reddevil578/speaker-switcher-remote/README.md

# speaker-switcher-remote
12V remote controlled audio component trigger as KiCAD project
