reddevil578/speaker-switcher-remote/PDF/speaker-switcher-remote-F_SilkS.pdf

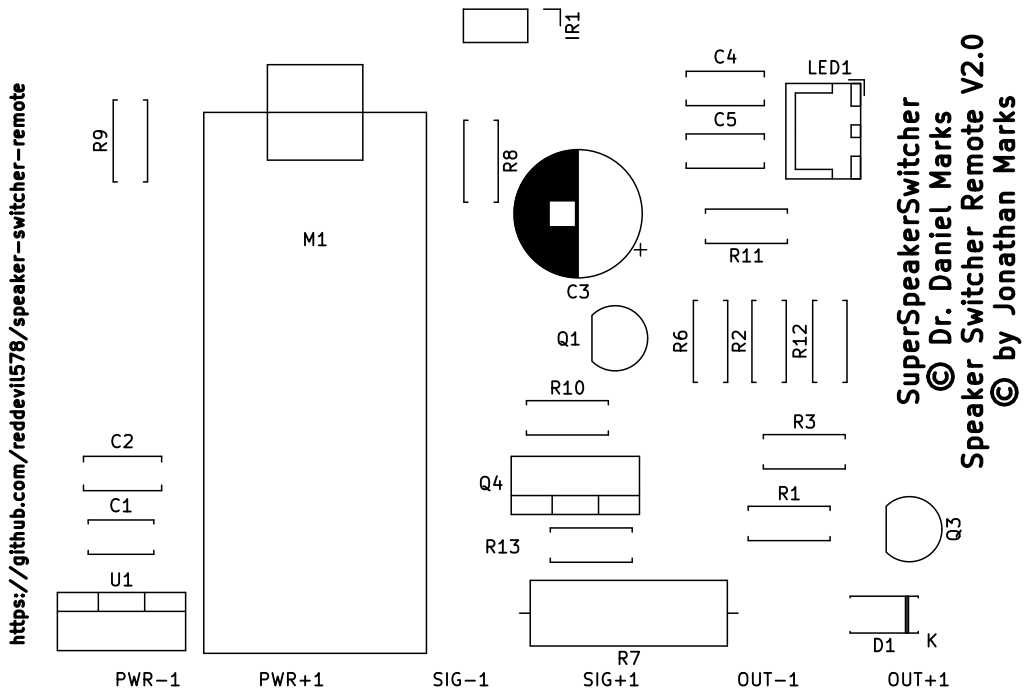
[picture p1: page 1]

https://github.com/reddevil578/speaker-switcher-remote SuperSpeakerSwitcher © Dr. Daniel Marks Speaker Switcher Remote V2.0 © by Jonathan Marks
