reddevil578/speaker-switcher-remote/PDF/speaker-switcher-remote-B_Cu.pdf

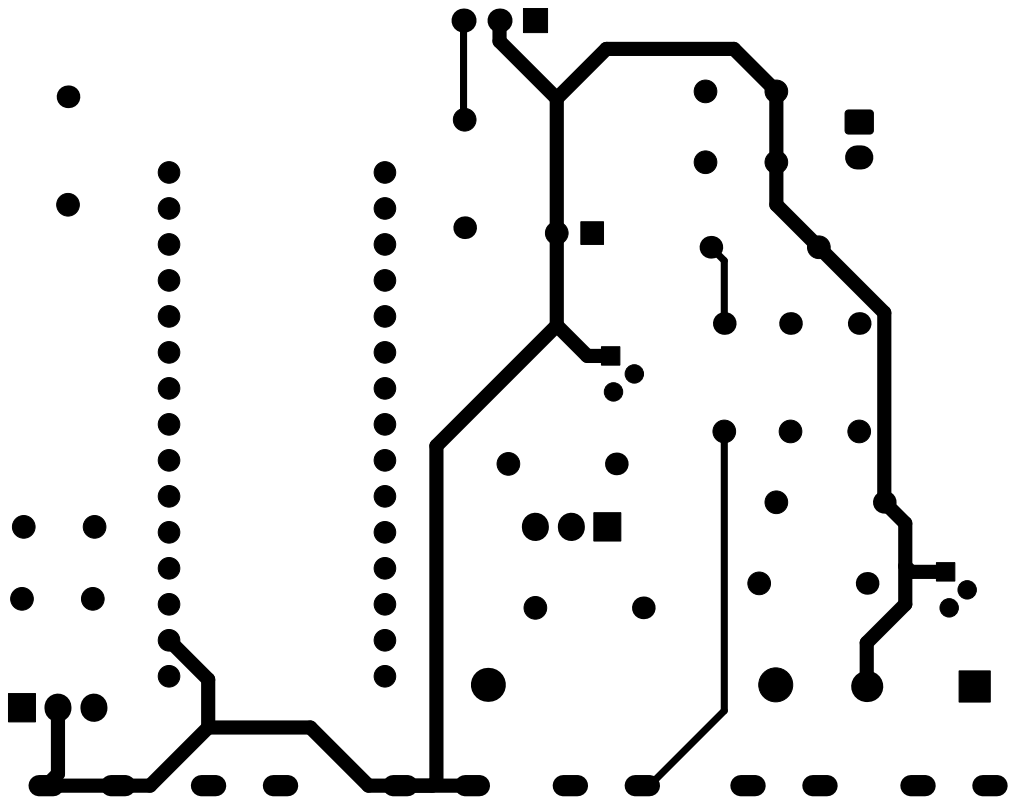
[picture p2: page 1]
