reddevil578/speaker-switcher-remote/PDF/speaker-switcher-remote-B_Mask.pdf

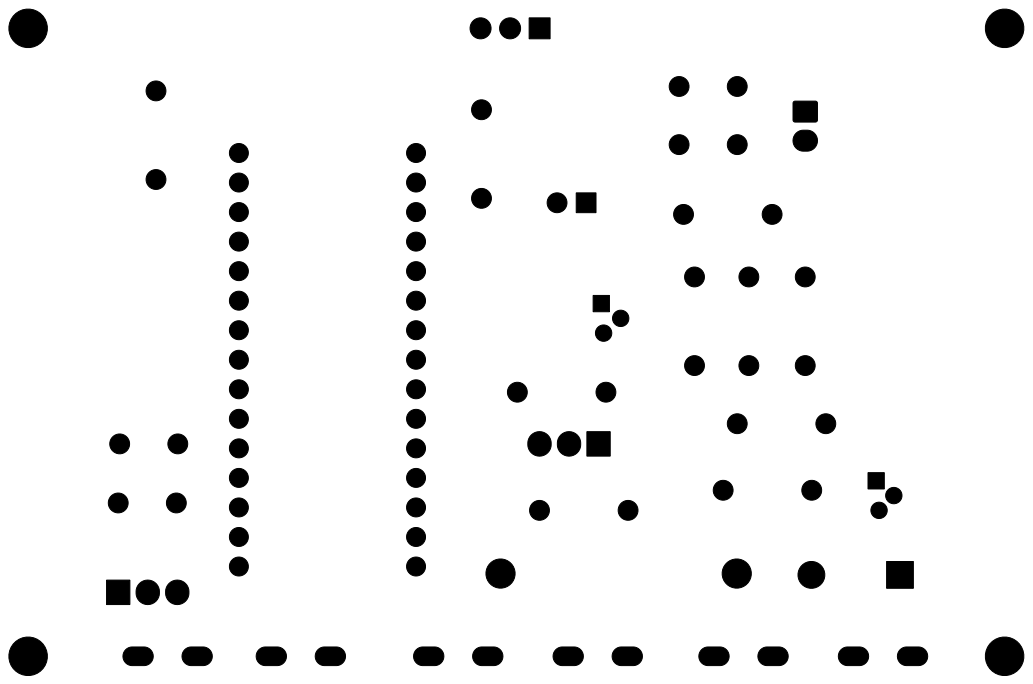
[picture p3: page 1]
