reddevil578/speaker-switcher-remote/PDF/speaker-switcher-remote-F_Cu.pdf

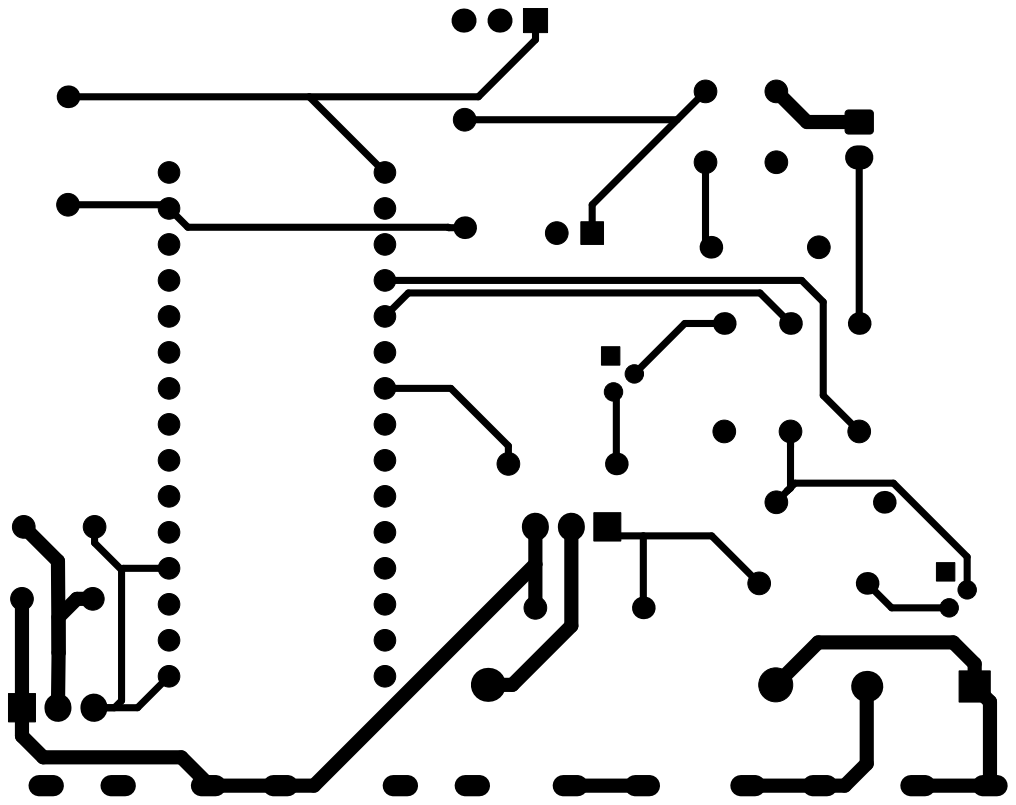
[picture p4: page 1]
