reddevil578/speaker-switcher-remote/PDF/speaker-switcher-remote-F_Fab.pdf

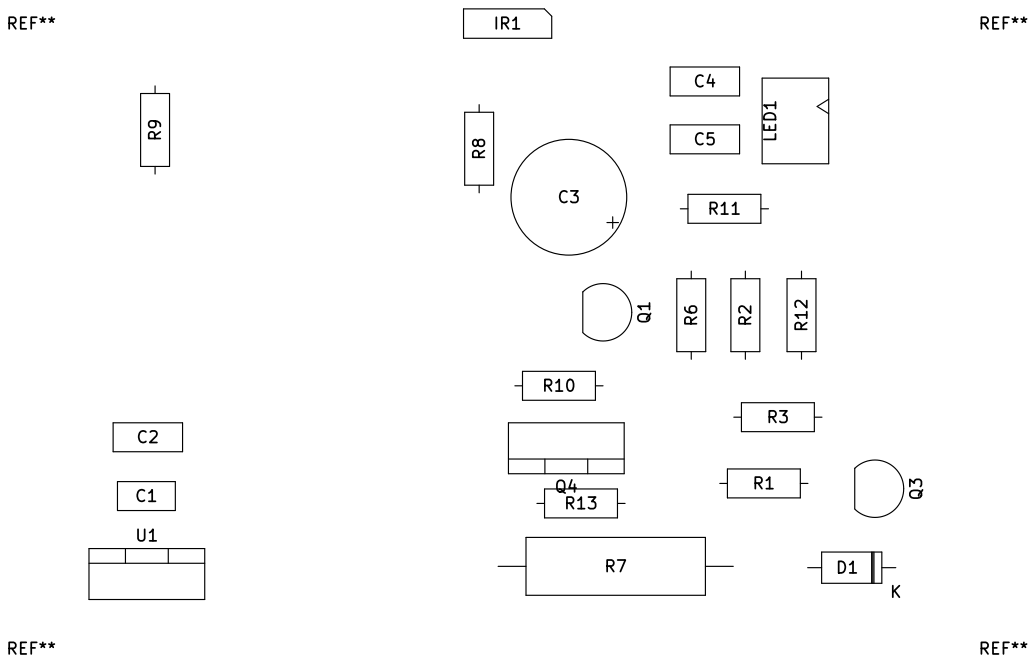
[picture p5: page 1]
