reddevil578/speaker-switcher-remote/speaker-switcher-remote.kicad_pcb

## KiCad design speaker-switcher-remote.kicad_pcb (2021-03-07)

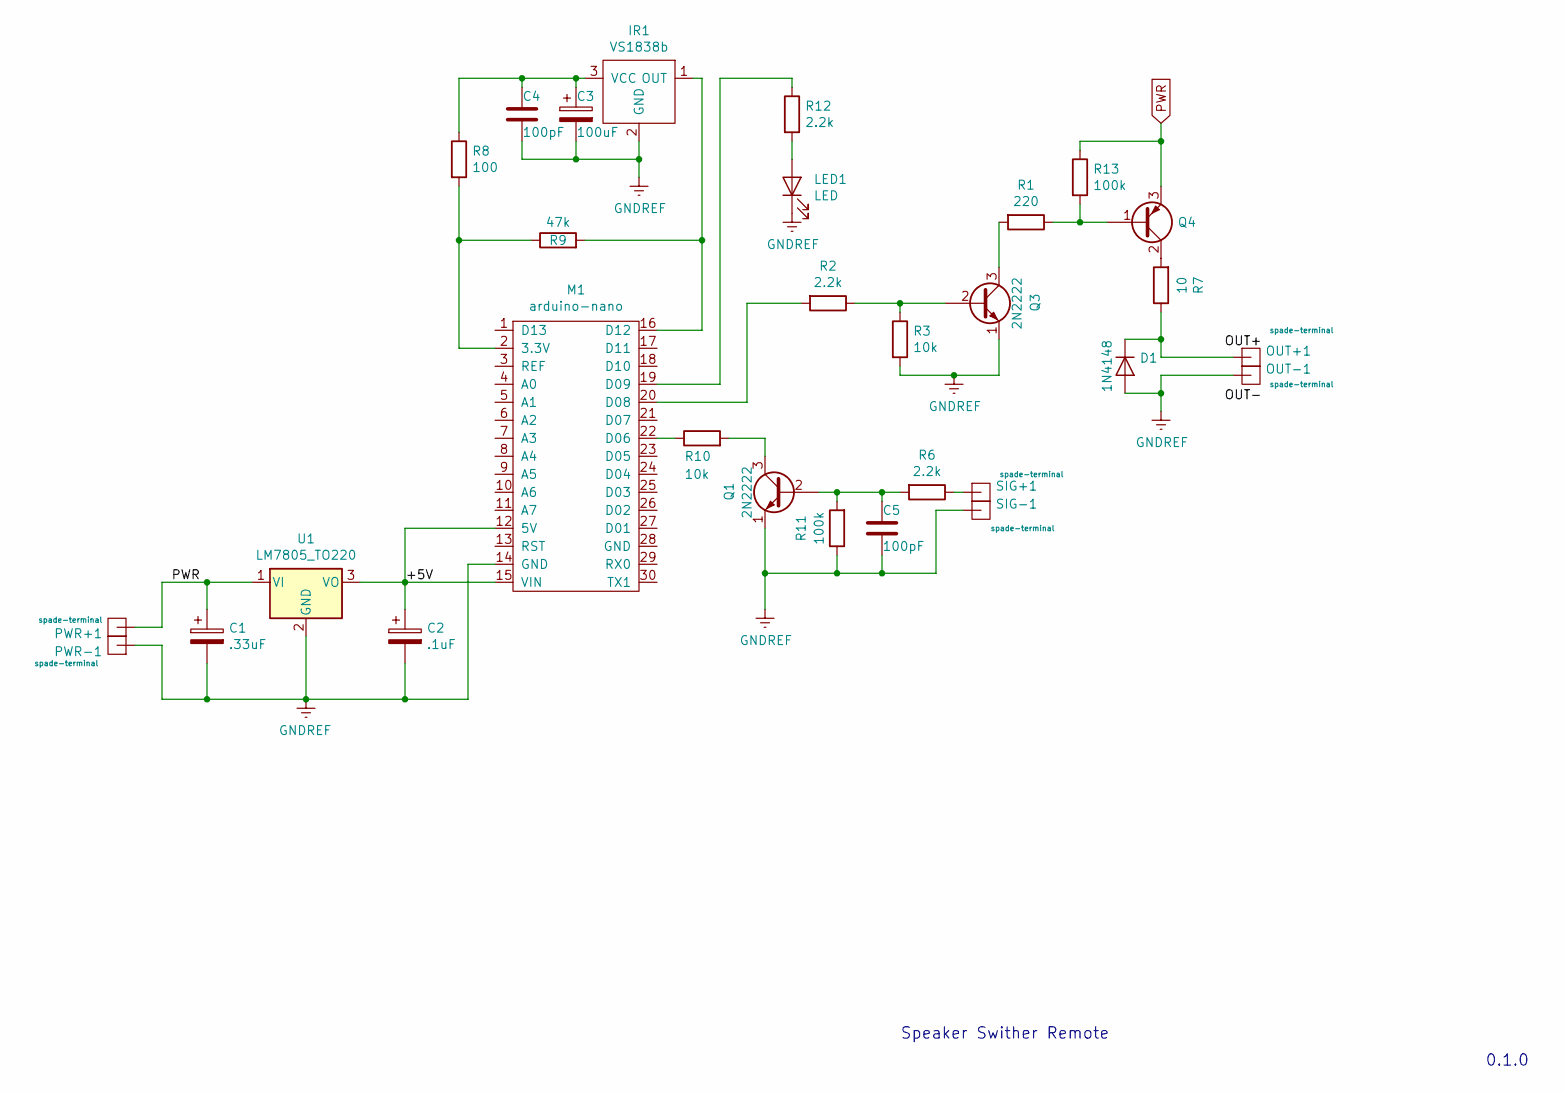
[picture p6: schematic speaker-switcher-remote.sch]

Parts:
C1: .33uF; C_Disc_D5.0mm_W2.5mm_P5.00mm
C2: .1uF; C_Disc_D6.0mm_W2.5mm_P5.00mm
C3: 100uF; CP_Radial_D10.0mm_P2.50mm
C4, C5: 100pF; C_Disc_D6.0mm_W2.5mm_P5.00mm
D1: 1N4148; D_DO-41_SOD81_P7.62mm_Horizontal
IR1: VS1838b; PinHeader_1x03_P2.54mm_Vertical
LED1: LED; JST_XH_B2B-XH-A_1x02_P2.50mm_Vertical
M1: arduino-nano
OUT+1: spade-terminal; SpadeTerminal635
OUT-1: spade-terminal; SpadeTerminal635
PWR+1: spade-terminal; SpadeTerminal635
PWR-1: spade-terminal; SpadeTerminal635
Q1, Q3: 2N2222; TO-92
Q4: Q_PNP_BCE; TO-220-3_Vertical
R1: 220; R_Axial_DIN0207_L6.3mm_D2.5mm_P7.62mm_Horizontal
R2, R6, R12: 2.2k; R_Axial_DIN0207_L6.3mm_D2.5mm_P7.62mm_Horizontal
R3, R10: 10k; R_Axial_DIN0207_L6.3mm_D2.5mm_P7.62mm_Horizontal
R7: 10; R_Axial_DIN0516_L15.5mm_D5.0mm_P20.32mm_Horizontal
R8: 100; R_Axial_DIN0207_L6.3mm_D2.5mm_P7.62mm_Horizontal
R9: 47k; R_Axial_DIN0207_L6.3mm_D2.5mm_P7.62mm_Horizontal
R11, R13: 100k; R_Axial_DIN0207_L6.3mm_D2.5mm_P7.62mm_Horizontal
SIG+1: spade-terminal; SpadeTerminal635
SIG-1: spade-terminal; SpadeTerminal635
U1: LM7805_TO220; TO-220-3_Vertical

Connections:
/+5V: C2.1, M1.12 (5V), M1.15 (VIN), U1.3 (VO)
GNDREF: C1.2, C2.2, C3.2, C4.2, C5.2, D1.2 (A), IR1.2 (GND), LED1.1 (K), M1.14 (GND), OUT-1.1, PWR-1.1, Q1.1 (E), Q3.1 (E), R3.2, R11.1, SIG-1.1, U1.2 (GND)
unnamed: C3.1, C4.1, IR1.3 (VCC), R8.1
unnamed: C5.1, Q1.2 (B), R6.2, R11.2
unnamed: D1.1 (K), OUT+1.1, R7.1
unnamed: IR1.1 (OUT), M1.16 (D12), R9.2
unnamed: LED1.2 (A), R12.2
unnamed: M1.2 (3.3V), R8.2, R9.1
unnamed: M1.19 (D09), R12.1
unnamed: M1.20 (D08), R2.2
unnamed: M1.22 (D06), R10.1
unnamed: Q1.3 (C), R10.2
unnamed: Q3.2 (B), R2.1, R3.1
unnamed: Q3.3 (C), R1.2
unnamed: Q4.1 (B), R1.1, R13.2
unnamed: Q4.2 (C), R7.2
unnamed: R6.1, SIG+1.1
PWR: C1.1, PWR+1.1, Q4.3 (E), R13.1, U1.1 (VI)

Notes on the sheet:
Speaker Swither Remote
0.1.0

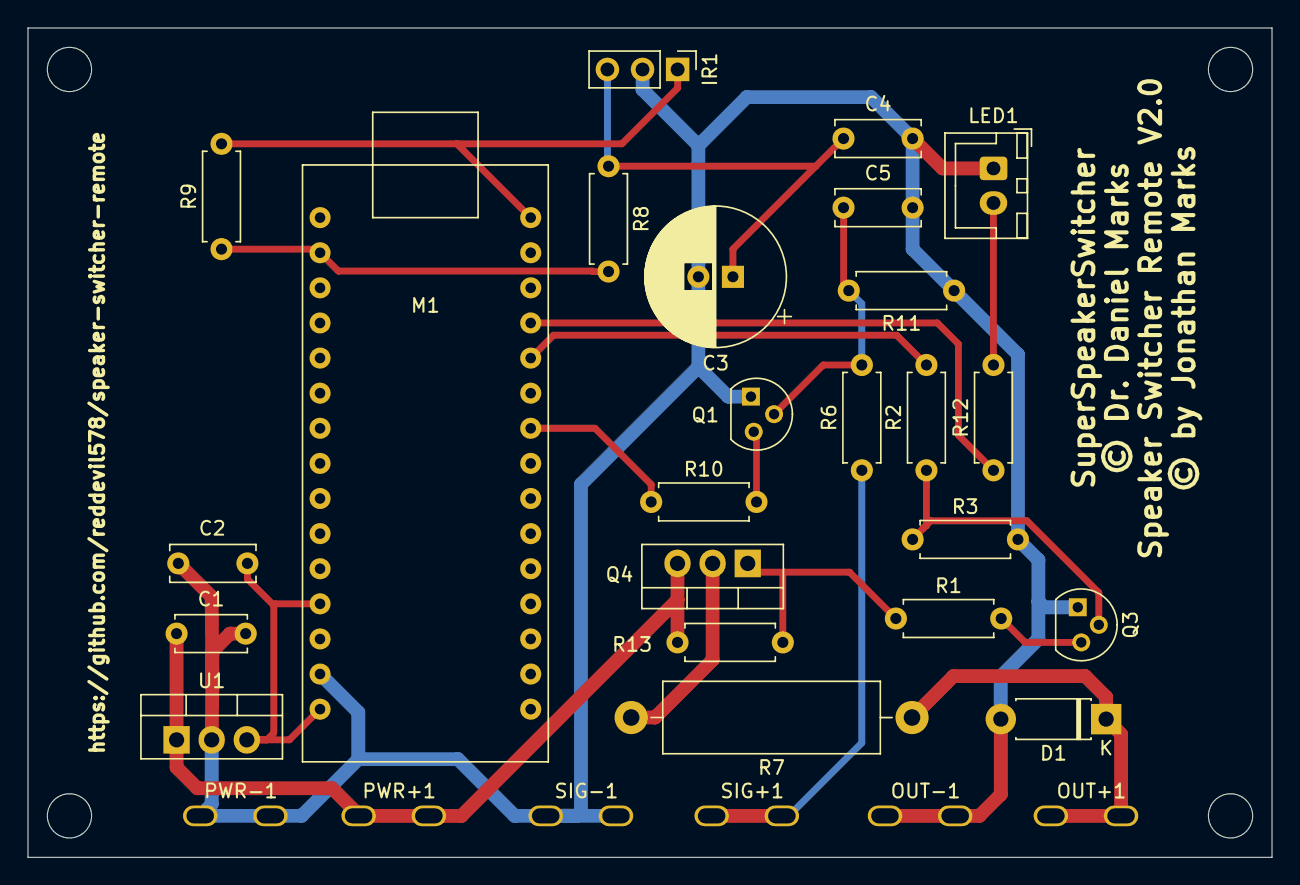
[picture p7: board speaker-switcher-remote.kicad_pcb from above]

Board: 2 copper layers, 90.0 x 60.0 mm, 30 parts (0 on the bottom side), 18 nets.
