reddevil578/speaker-switcher-remote/(commit log)

2021-01-23 Initial design
    [speaker-switcher-remote.kicad_pcb, speaker-switcher-remote.sch]
2021-01-23 Updated with arduino src code
    [speaker-switcher-remote-B_Cu.gbl, speaker-switcher-remote-B_Fab.gbr, speaker-switcher-remote-B_Mask.gbs, speaker-switcher-remote-B_Paste.gbp, speaker-switcher-remote-B_SilkS.gbo, speaker-switcher-remote-Edge_Cuts.gm1, speaker-switcher-remote-F_Cu.gtl, speaker-switcher-remote-F_Fab.gbr]
2021-01-23 Moved items
    [speaker-switcher-remote.drl]
2021-01-23 Commented, cleanup up, and moved arduino sketch
2021-01-25 Moved labels
    [speaker-switcher-remote-B_Cu.gbl, speaker-switcher-remote-B_Fab.gbr, speaker-switcher-remote-B_Mask.gbs, speaker-switcher-remote-B_Paste.gbp, speaker-switcher-remote-B_SilkS.gbo, speaker-switcher-remote-Edge_Cuts.gm1, speaker-switcher-remote-F_Cu.gtl, speaker-switcher-remote-F_Fab.gbr]
2021-01-30 Updated as per Dan's recommendations
    [speaker-switcher-remote.sch]
2021-01-30 Reworking pcb
    [speaker-switcher-remote.kicad_pcb]
2021-01-30 Updated board
    [speaker-switcher-remote.kicad_pcb, speaker-switcher-remote.sch]
2021-01-30 New PCB layout
    [speaker-switcher-remote-B_Cu.gbl, speaker-switcher-remote-B_Fab.gbr, speaker-switcher-remote-B_Mask.gbs, speaker-switcher-remote-B_Paste.gbp, speaker-switcher-remote-B_SilkS.gbo, speaker-switcher-remote-Edge_Cuts.gm1, speaker-switcher-remote-F_Cu.gtl, speaker-switcher-remote-F_Fab.gbr]
2021-01-30 Stabilize signal input
    [speaker-switcher-remote-B_Cu.gbl, speaker-switcher-remote-B_Fab.gbr, speaker-switcher-remote-B_Mask.gbs, speaker-switcher-remote-B_Paste.gbp, speaker-switcher-remote-B_SilkS.gbo, speaker-switcher-remote-Edge_Cuts.gm1, speaker-switcher-remote-F_Cu.gtl, speaker-switcher-remote-F_Fab.gbr]
2021-01-31 Updated PCB but not plots
    [speaker-switcher-remote.kicad_pcb, speaker-switcher-remote.sch]
2021-01-31 Updated plots
    [speaker-switcher-remote-B_Cu.gbl, speaker-switcher-remote-B_Fab.gbr, speaker-switcher-remote-B_Mask.gbs, speaker-switcher-remote-B_Paste.gbp, speaker-switcher-remote-B_SilkS.gbo, speaker-switcher-remote-Edge_Cuts.gm1, speaker-switcher-remote-F_Cu.gtl, speaker-switcher-remote-F_Fab.gbr]
2021-01-31 Elongated board to required mounting width
    [speaker-switcher-remote-B_Cu.gbl, speaker-switcher-remote-B_Fab.gbr, speaker-switcher-remote-B_Mask.gbs, speaker-switcher-remote-B_Paste.gbp, speaker-switcher-remote-B_SilkS.gbo, speaker-switcher-remote-Edge_Cuts.gm1, speaker-switcher-remote-F_Cu.gtl, speaker-switcher-remote-F_Fab.gbr]
2021-02-01 Updated board as per Dan's remarks
    [speaker-switcher-remote-B_Cu.gbl, speaker-switcher-remote-B_Fab.gbr, speaker-switcher-remote-B_Mask.gbs, speaker-switcher-remote-B_Paste.gbp, speaker-switcher-remote-B_SilkS.gbo, speaker-switcher-remote-Edge_Cuts.gm1, speaker-switcher-remote-F_Cu.gtl, speaker-switcher-remote-F_Fab.gbr]
2021-02-13 Added indicator LED to d09
    [speaker-switcher-remote-B_Cu.gbl, speaker-switcher-remote-B_Fab.gbr, speaker-switcher-remote-B_Mask.gbs, speaker-switcher-remote-B_Paste.gbp, speaker-switcher-remote-B_SilkS.gbo, speaker-switcher-remote-Edge_Cuts.gm1, speaker-switcher-remote-F_Cu.gtl, speaker-switcher-remote-F_Fab.gbr]
2021-02-14 Update for latest circuit changes
2021-03-07 Updated w/PNP output stage
    [speaker-switcher-remote-B_Cu.gbl, speaker-switcher-remote-B_Fab.gbr, speaker-switcher-remote-B_Mask.gbs, speaker-switcher-remote-B_Paste.gbp, speaker-switcher-remote-B_SilkS.gbo, speaker-switcher-remote-Edge_Cuts.gm1, speaker-switcher-remote-F_Cu.gtl, speaker-switcher-remote-F_Fab.gbr]
2021-03-07 Rev 2.0
    [speaker-switcher-remote-B_Cu.gbl, speaker-switcher-remote-B_Fab.gbr, speaker-switcher-remote-B_Mask.gbs, speaker-switcher-remote-B_Paste.gbp, speaker-switcher-remote-B_SilkS.gbo, speaker-switcher-remote-Edge_Cuts.gm1, speaker-switcher-remote-F_Cu.gtl, speaker-switcher-remote-F_Fab.gbr]
2021-03-07 Fixed trace width
    [speaker-switcher-remote-B_Cu.gbl, speaker-switcher-remote-B_Fab.gbr, speaker-switcher-remote-B_Mask.gbs, speaker-switcher-remote-B_Paste.gbp, speaker-switcher-remote-B_SilkS.gbo, speaker-switcher-remote-Edge_Cuts.gm1, speaker-switcher-remote-F_Cu.gtl, speaker-switcher-remote-F_Fab.gbr]
